Oshlo/ENMT301-Robo-Cup/README.md

# RoboCup Group 4

Hank Wu
Georgia Reynolds
Adam Finlayson

Will need to download TaskScheduler in the library manager.
