Oshlo/ENMT301-Robo-Cup/RoboCupGroup4/motors.h

//************************************
//         motors.h    
//************************************

#ifndef MOTORS_H_
#define MOTORS_H_

// SET THIS TO REAL VALUES
#define LEFT_MOTOR_ADDRESS 1      //Pin corresponding to the left dc motor
#define RIGHT_MOTOR_ADDRESS 1     //Pin corresponding to the right dc motor
#define MIN_SPEED_CAP 1           //Set the minimum speed value that can be written to the motors
#define MAX_SPEED_CAP 1           //Set the maximum speed value that can be written to the motors


enum{MOTOR_LEFT, MOTOR_RIGHT};
enum{MOTOR_FORWARD, MOTOR_REVERSE, MOTOR_STOP};


void set_motor(int motor,int dir, int motor_speed_percentage);
void motor_init();
int get_stepper_speed();

#endif /* MOTORS_H_ */
