Oshlo/ENMT301-Robo-Cup/RoboCupGroup4/myServo.h

//************************************
//         myServo.h
//************************************
void myservo_callback();
void myservo_init();
void set_servo_velocity(int percentage);
void servo_out();
void servo_in();
bool is_servo_activated();
bool is_servo_in();
bool is_servo_out();
