Oshlo/ENMT301-Robo-Cup/RoboCupGroup4/sensors.h

//************************************
//         sensors.h     
//************************************

#ifndef SENSORS_H_
#define SENSORS_H_

// Read ultrasonic value
void read_ultrasonic(/* Parameters */);

// Read infrared value
void read_infrared(/* Parameters */);

void read_colour(/* Parameters */);

// Pass in data and average the lot
void sensor_average(/* Parameters */);
bool check_weight();


#endif /* SENSORS_H_ */
