Oshlo/ENMT301-Robo-Cup/RoboCupGroup4/longRangeIR.h

#ifndef LONGRANGEIR_H_
#define LONGRANGEIR_H_

#define LongIRR A6
#define LongIRL A7

void longRangeIR_init();
void longRangeIRRCallback();
void longRangeIRLCallback();
float getLongRangeIRR();
float getLongRangeIRL();

#endif /* LONGRANGEIR_H_ */
