Oshlo/ENMT301-Robo-Cup/RoboCupGroup4/midRangeIR.h

#ifndef MIDRANGEIR_H_
#define MIDRANGEIR_H_

#define MidIRR A10
#define MidIRL A11

void midRangeIR_init();
void midRangeIRRCallback();
void midRangeIRLCallback();
float getMidRangeIRR();
float getMidRangeIRL();
float getMidRawR();

#endif /* MIDRANGEIR_H_ */
