Oshlo/ENMT301-Robo-Cup/RoboCupGroup4/weight_collection.cpp

/************************************
 *        weight_collection.cpp       *
 *************************************/

 /* This is for functions and tasks for
  *  finding and collecting weights  */


#include "weight_collection.h"
#include "Arduino.h"

void weight_scan(/* whatever parameters */) 
{
  /* Use sensors to search for weights,
   * Switch to WEIGHT_FOUND state if a weight is found   */
   Serial.println("Looking for weights \n");
}


void collect_weight()
{
  /* When ready, collect the weight */
   Serial.println("Collecting weight \n");
}
